xlazam01/OpenWheel/cad/diy/ofw_diy_bearing_mf105zz.png

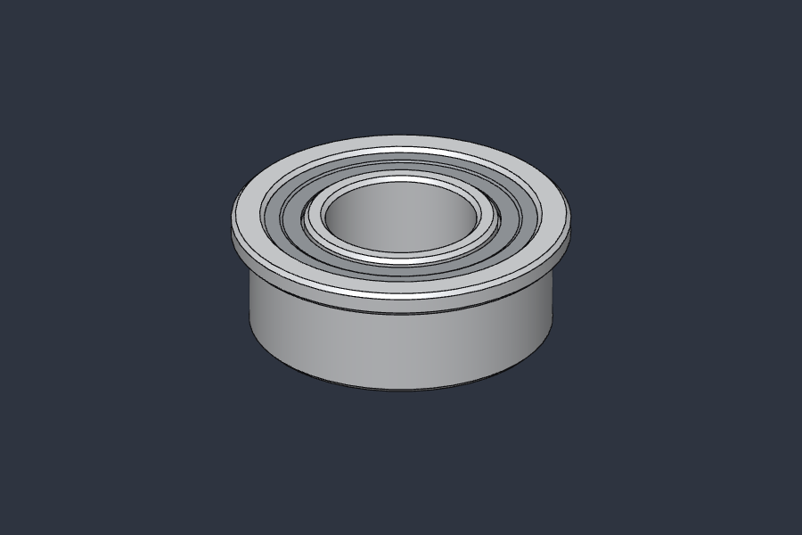
cad/diy/ofw_diy_bearing_mf105zz.png
