xlazam01/OpenWheel/cad/diy/ofw_diy_plate_camera.png

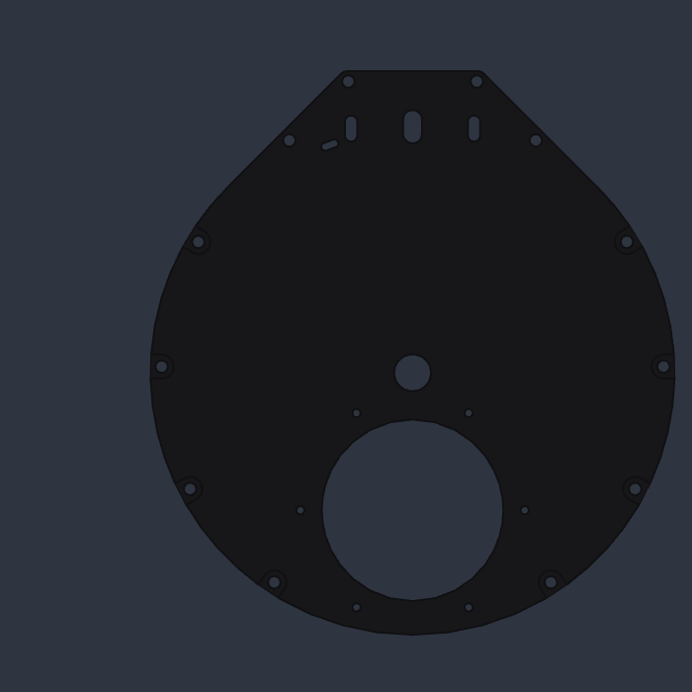
cad/diy/ofw_diy_plate_camera.png
