xlazam01/OpenWheel/cad/diy/ofw_diy_screw_m3x8_lowhead.png

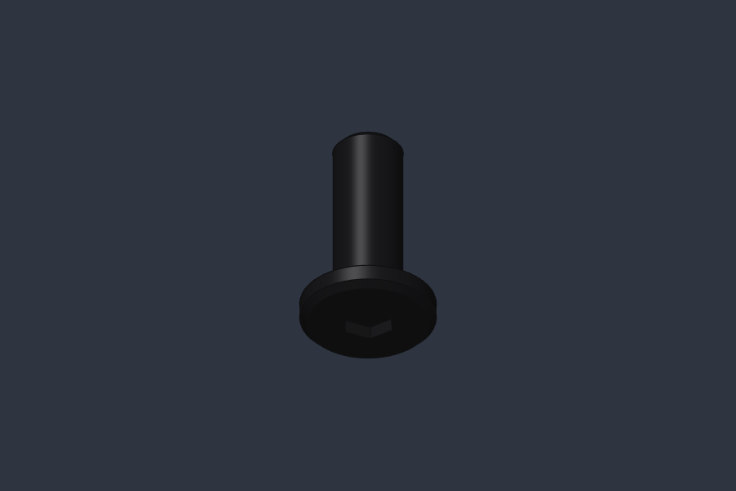
cad/diy/ofw_diy_screw_m3x8_lowhead.png
