xlazam01/OpenWheel/cad/diy/ofw_diy_shell.png

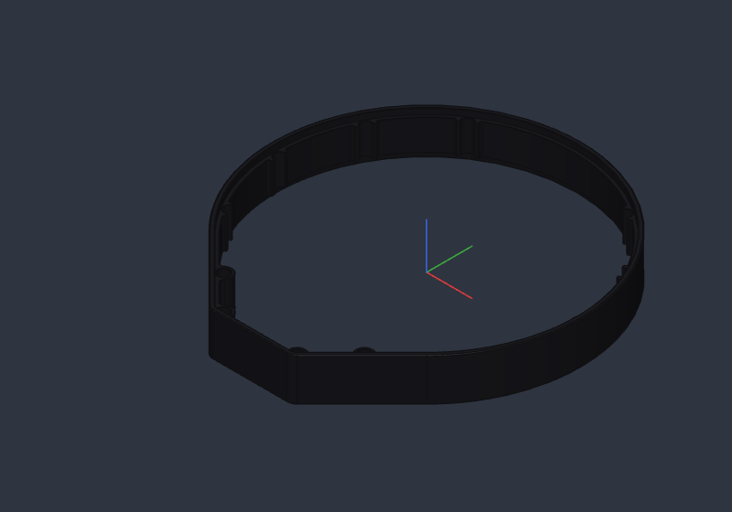
cad/diy/ofw_diy_shell.png
