xlazam01/OpenWheel/cad/diy/ofw_diy_wheel_asm.png

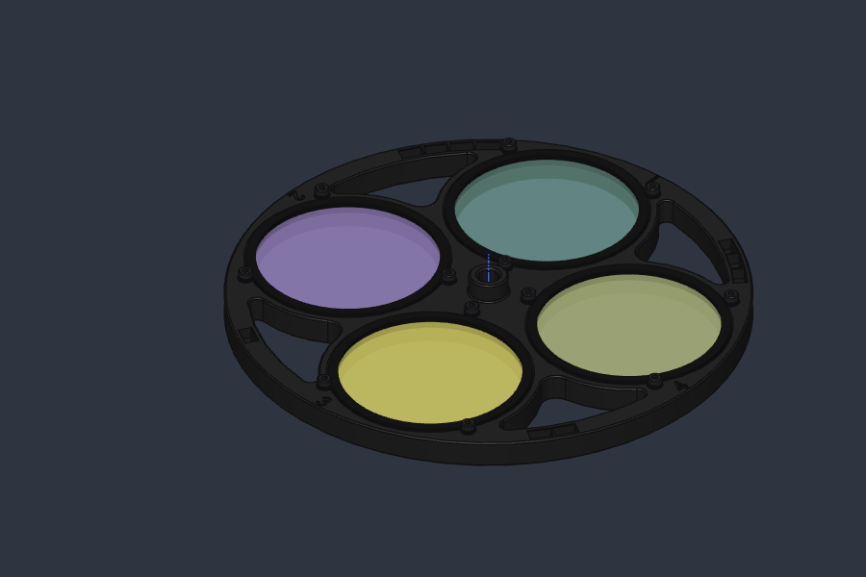
cad/diy/ofw_diy_wheel_asm.png
