xlazam01/OpenWheel/docs/hw/pcb_bottom.png

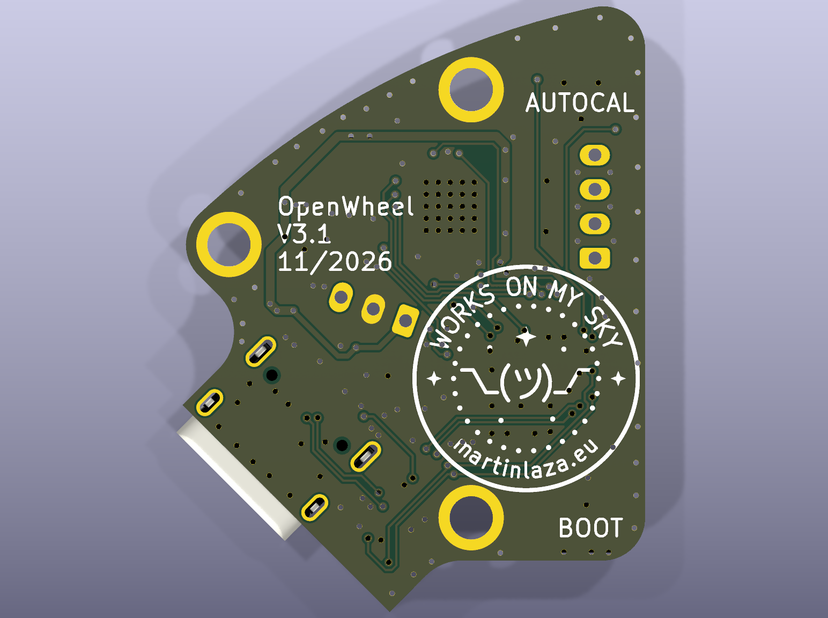
docs/hw/pcb_bottom.png
