xlazam01/OpenWheel/docs/hw/pcb_iso.png

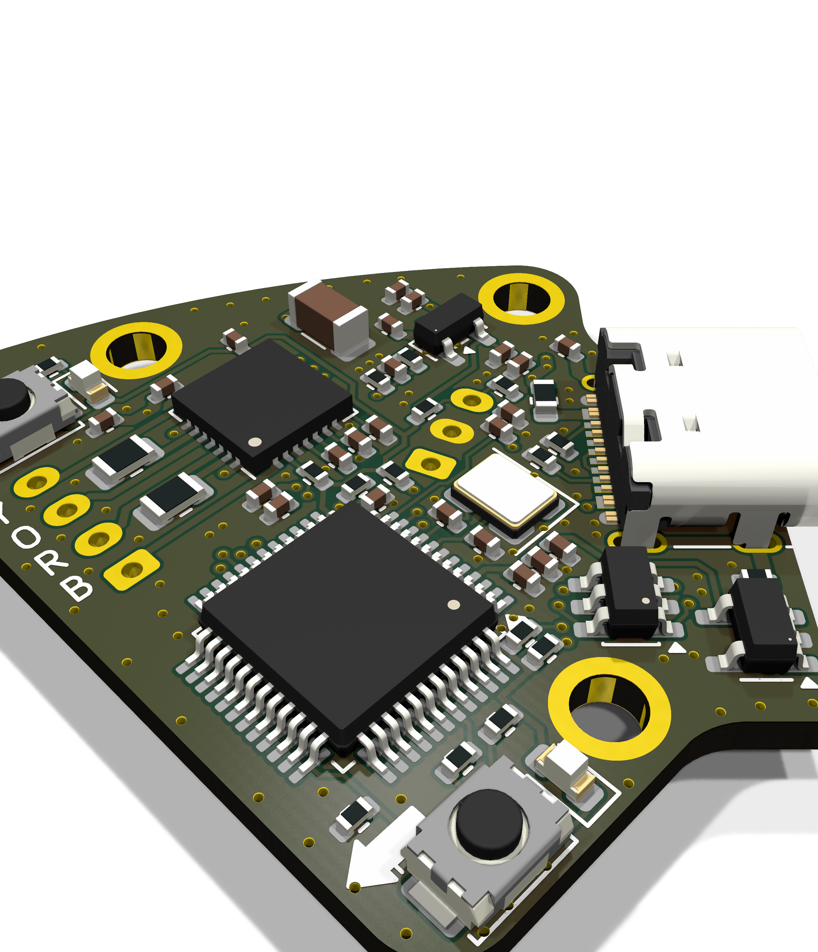
docs/hw/pcb_iso.png
