xlazam01/OpenWheel/docs/hw/pcb_top.png

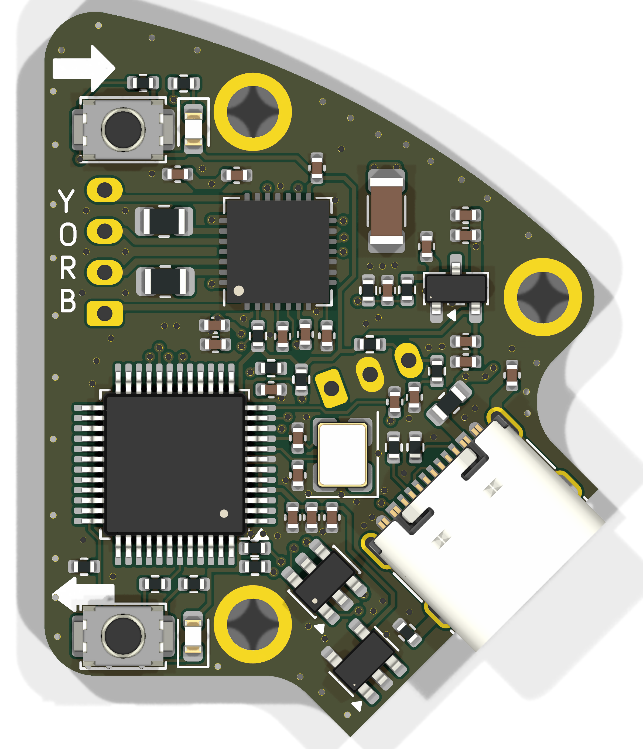
docs/hw/pcb_top.png
