xlazam01/OpenWheel/release/1.0.0/pcb/OpenWheel-bom-jlc.csv

Comment | Designator | Footprint | LCSC
4.7nF | C1 | C_0402_1005Metric | C1538
12pF | C11,C12 | C_0402_1005Metric | C1547
100nF/50V | C14,C15,C20,C22 | C_0402_1005Metric | C307331
47uF/10V | C18 | C_1206_3216Metric | C96123
22nF/50V | C19 | C_0402_1005Metric | C1532
1uF | C2,C3,C10 | C_0402_1005Metric | C52923
1nF | C24 | C_0402_1005Metric | C1523
100nF | C4,C7,C8,C9,C13,C23,C25 | C_0402_1005Metric | C1525
22nF | C5 | C_0402_1005Metric | C1532
10uF/10V | C6,C16,C17,C21 | C_0402_1005Metric | C315248
RED | D1,D2 | LED_0603_1608Metric | C2286
SMD0603P050TF | F1 | Fuse_0603_1608Metric | C20789
MC-311D | J1 | USB_C_Receptacle_G-Switch_GT-USB-7010ASV | C2988369
5k1 | R1,R2,R10,R11,R12,R13 | R_0402_1005Metric | C25905
1k5 | R15 | R_0402_1005Metric | C25867
0.11R | R16,R17 | R_0805_2012Metric | C5126077
100R | R19 | R_0402_1005Metric | C25076
1M | R3 | R_0402_1005Metric | C26083
10k | R4,R7,R9,R14,R18,R20,R21 | R_0402_1005Metric | C25744
510R | R8 | R_0402_1005Metric | C25123
CCW / BOOT0 | SW2 | SW_Push_SPST_NO_Alps_SKRK | C720477
CW | SW3 | SW_Push_SPST_NO_Alps_SKRK | C720477
USBLC6-2SC6 | U1 | SOT-23-6 | C2687116
RT9193-33 | U2 | SOT-23-5 | C15651
STM32G0B1CBTx | U3 | LQFP-48_7x7mm_P0.5mm | C2847904
24AA64T-I/OT | U4 | SOT-23-5 | C2061092
TMC2209-LA | U5 | QFN-28-1EP_5x5mm_P0.5mm_EP3.75x3.75mm_ThermalVias | C2150710
TAXM8M4RDBCCT2T / 8MHz | Y1 | Crystal_SMD_3225-4Pin_3.2x2.5mm | C400090
