xlazam01/OpenWheel/(list of files, cad)

Other CAD files:
cad/diy/ofw_diy_wheel_asm.step
cad/triton/ofw_triton_motor_plate.step
hw/3dmodels/Fuse_0603_1608Metric.step
release/1.0.0/cad/printed/ofw_diy_motorbox.3mf
release/1.1.0/cad/cnc/ofw_diy_plate_front.step
release/1.1.0/cad/printed/ofw_diy_wheel.step
release/1.1.0/pcb/kicad/hw/3dmodels/SW_Push_SPST_NO_Alps_SKRK.step
cad/diy/ofw_diy_shaft_5x20.step
cad/triton/ofw_triton_shell.3mf
release/1.0.0/cad/printed/ofw_diy_motorbox_lid.step
release/1.1.0/cad/printed/ofw_diy_motorbox.step
release/1.1.0/cad/printed/ofw_diy_shell.3mf
release/1.1.0/cad/printed/ofw_diy_motorbox_lid.3mf
cad/diy/ofw_diy_standoff_m3x15.step
cad/diy/ofw_diy_bearing_mf105zz.step
cad/diy/ofw_diy_shell.step
cad/diy/ofw_diy_wheel.step
cad/diy/ofw_diy_pcb_board.step
cad/diy/ofw_diy_shim_5x7x05.step
cad/diy/ofw_diy_shim_10x14x03.step
cad/diy/ofw_diy_pcb.step
cad/diy/GT-USB-7010ASV.step
cad/diy/ofw_diy_screw_iso7380_m3x16.step
cad/diy/ofw_diy_screw_iso7380_m3x8.step
cad/diy/ofw_diy_screw_m2x6_socket.step
cad/diy/ofw_diy_screw_m3x8_lowhead.step
cad/triton/ofw_triton_motor_plate.3mf
