xlazam01/OpenWheel/docs/build/page00.png

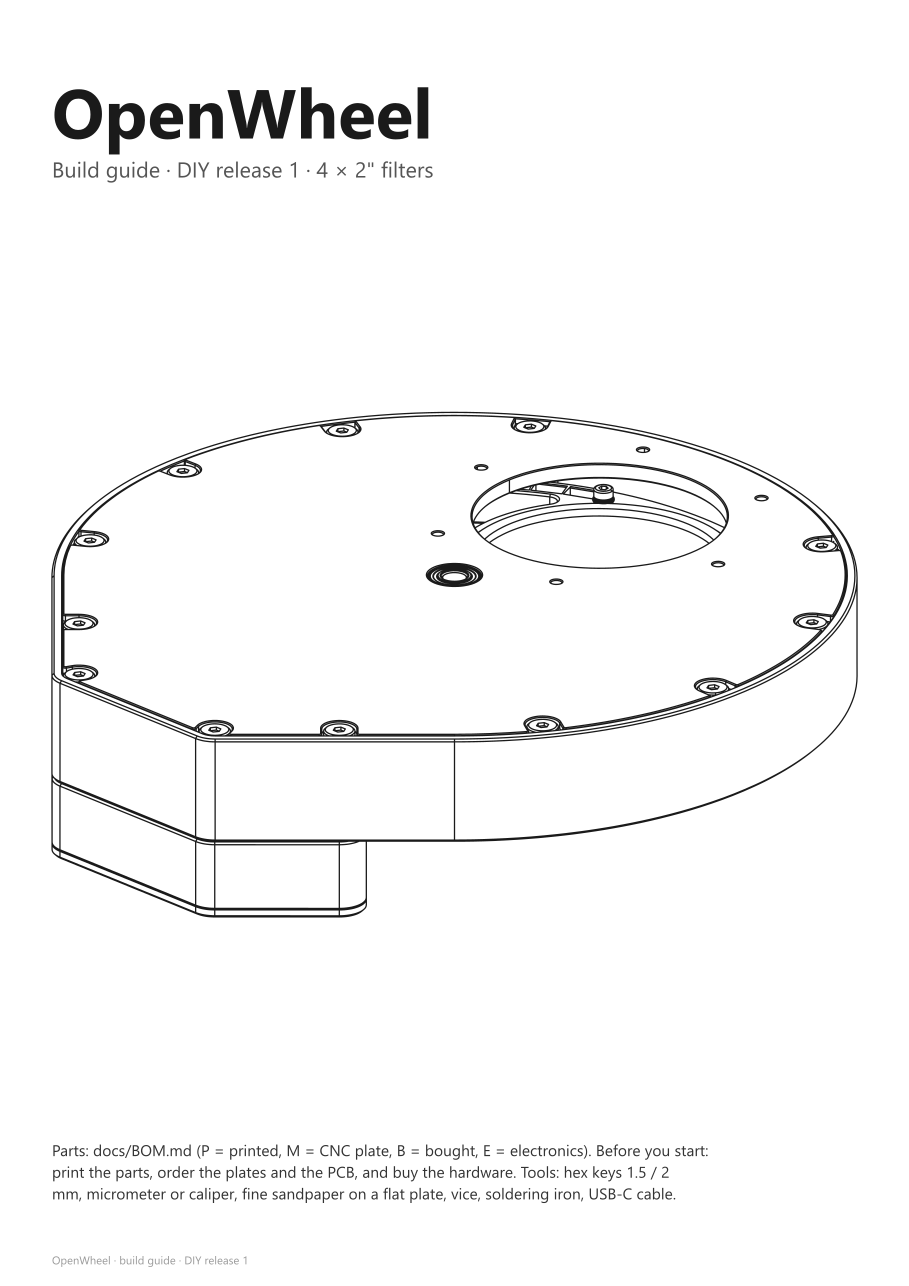
docs/build/page00.png
