xlazam01/OpenWheel/hw/filter_wheel.kicad_pcb

## KiCad design hw/filter_wheel.kicad_pcb (2026-11-09)

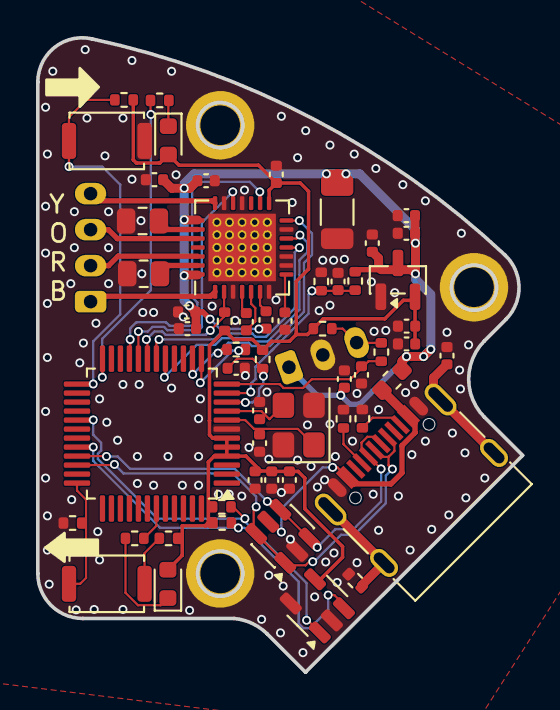
[picture p30: board filter_wheel.kicad_pcb from above]

Board: 2 copper layers, 26.9 x 35.2 mm, 61 parts (1 on the bottom side), 41 nets.

Parts:
C1: 4.7nF; C_0402_1005Metric
C2, C3, C10: 1uF; C_0402_1005Metric
C4, C7, C8, C9, C13, C14, C15, C20, C22, C23, C25: 100nF; C_0402_1005Metric
C6, C16, C17, C21: 10uF/10V; C_0402_1005Metric
C11, C12: 12pF; C_0402_1005Metric
C18: 47uF/10V; C_1206_3216Metric
C19: 22nF/50V; C_0402_1005Metric
C24: 1nF; C_0402_1005Metric
D1, D2: RED; LED_0603_1608Metric
F1: SMD0603P050TF; Fuse_0603_1608Metric
G1: Logo_WorksOnMySky_13mm
H1, H2, H3: M2; MountingHole_2.2mm_M2_DIN965_Pad
J1: MC-311D; USB_C_Receptacle_G-Switch_GT-USB-7010ASV
J3: Motor; JST_PH_B4B-PH-K_1x04_P2.00mm_Vertical
J4: Hall; JST_PH_B3B-PH-K_1x03_P2.00mm_Vertical
R1, R2, R10, R11, R12, R13: 5k1; R_0402_1005Metric
R3: 1M; R_0402_1005Metric
R4, R7, R9, R14, R18, R20, R21: 10k; R_0402_1005Metric
R8: 510R; R_0402_1005Metric
R15: 1k5; R_0402_1005Metric
R16, R17: 0.11R; R_0805_2012Metric
R19: 100R; R_0402_1005Metric
SW2: CCW / BOOT0; SW_Push_SPST_NO_Alps_SKRK
SW3: CW; SW_Push_SPST_NO_Alps_SKRK
U1: USBLC6-2SC6; SOT-23-6
U2: ME6231A33M3G; SOT-23
U3: STM32G0B1CBTx; LQFP-48_7x7mm_P0.5mm
U4: 24AA64T-I/OT; SOT-23-5
U5: TMC2209-LA; QFN-28-1EP_5x5mm_P0.5mm_EP3.75x3.75mm_ThermalVias
Y1: TAXM8M4RDBCCT2T / 8MHz; Crystal_SMD_3225-4Pin_3.2x2.5mm

Connections:
+3.3V: C6.1, C7.1, C8.1, C9.1, C10.1, C22.2, D1.2 (A), D2.2 (A), R4.2, R8.2, R9.2, R12.2, R13.2, R14.2, R18.1, U2.2, U3.4 (VBAT), U3.5 (VREF+), U3.6 (VDD), U4.4 (V_{CC}), U5.15 (VCC_IO)
+5V: C2.2, C3.1, C4.1, C14.2, C15.2, C16.2, C17.2, C18.1, C20.1, C23.1, F1.2, J4.1, R20.1, U2.3, U5.22 (VS), U5.28 (VS)
/BTN_CCW: R8.1, SW2.2
/BTN_CW: R9.1, SW3.2, U3.25 (PB13)
/HALL: C24.1, R19.2, U3.12 (PA1)
/HALL_IN: J4.3, R18.2, R19.1
/I2C_SCL: R12.1, U3.29 (PA9/UCPD1_DBCC1), U4.1 (SCL)
/I2C_SDA: R13.1, U3.32 (PA10/UCPD1_DBCC2), U4.3 (SDA)
/LED1: R10.1, U3.24 (PB12)
/LED1_K: D1.1 (K), R10.2
/LED2: R11.1, U3.43 (PB4)
/LED2_K: D2.1 (K), R11.2
/MOT_A1: J3.3, U5.24 (OA1)
/MOT_A2: J3.4, U5.21 (OA2)
/MOT_B1: J3.2, U5.26 (OB1)
/MOT_B2: J3.1, U5.1 (OB2)
/NRST: C13.1, R4.1, U3.10 (PF2)
/OSC_IN: C11.1, U3.8 (PF0), Y1.1
/OSC_OUT: C12.1, U3.9 (PF1), Y1.3
/SWCLK_BOOT0: R7.2, SW2.1, U3.36 (PA14)
/TMC_5VOUT: C21.2, U5.8 (5VOUT)
/TMC_BRA: R16.1, U5.23 (BRA)
/TMC_BRB: R17.1, U5.27 (BRB)
/TMC_CPI: C19.1, U5.5 (CPI)
/TMC_CPO: C19.2, U5.4 (CPO)
/TMC_DIAG: U3.18 (PA7), U5.11 (DIAG)
/TMC_DIR: U3.20 (PB1), U5.19 (DIR)
/TMC_EN: R14.1, U3.19 (PB0), U5.2 (~EN)
/TMC_INDEX: U3.17 (PA6), U5.12 (INDEX)
/TMC_STEP: U3.21 (PB2), U5.16 (STEP)
/TMC_TX: R15.2, U3.13 (PA2)
/TMC_UART: R15.1, U3.14 (PA3), U5.14 (~PD/UART)
/TMC_VCP: C20.2, U5.6 (VCP)
/USB_CC1: J1.A5 (CC1), R1.1
/USB_CC2: J1.B5 (CC2), R2.1
/USB_DM: J1.A7 (D-), J1.B7 (D-), U1.3 (I/O2), U1.4 (I/O2), U3.33 (PA9/PA11)
/USB_DP: J1.A6 (D+), J1.B6 (D+), U1.1 (I/O1), U1.6 (I/O1), U3.34 (PA10/PA12)
/USB_SHIELD: C1.1, J1.S1 (SHIELD), R3.1
/V5_SENSE: C25.1, R20.2, R21.1, U3.11 (PA0)
GND: C1.2, C2.1, C3.2, C4.2, C6.2, C7.2, C8.2, C9.2, C10.2, C11.2, C12.2, C13.2, C14.1, C15.1, C16.1, C17.1, C18.2, C21.1, C22.1, C23.2, C24.2, C25.2, H1.1 (1_1), H2.1 (1_1), H3.1 (1_1), J1.A1 (GND), J1.A12 (GND), J1.B1 (GND), J1.B12 (GND), J4.2, R1.2, R2.2, R3.2, R7.1, R16.2, R17.2, R21.2, SW3.1, U1.2 (GND), U2.1, U3.7 (VSS), U4.2 (V_{SS}), U4.5 (WP), U5.3 (GND), U5.7 (SPREAD), U5.9 (MS1/AD0), U5.10 (MS2/AD1), U5.13 (CLK), U5.18 (GND), U5.20 (STDBY), U5.29 (GND), Y1.2 (G), Y1.4 (G)
VBUS: F1.1, J1.A4 (VBUS), J1.A9 (VBUS), J1.B4 (VBUS), J1.B9 (VBUS), U1.5 (VBUS)
