xlazam01/OpenWheel/tools/gui/main.py

"""
OpenWheel Filter Control Application
Main entry point
"""

import sys
from PyQt5.QtWidgets import QApplication
from main_window import MainWindow


def main():
    app = QApplication(sys.argv)
    app.setStyle('Fusion')  # Modern look

    window = MainWindow()
    window.show()

    sys.exit(app.exec_())


if __name__ == "__main__":
    main()
