xlazam01/OpenWheel/(commit log)

2026-11-05 feat: OpenWheel open-source filter wheel
    STM32G0B1 firmware, KiCad PCB (V3.1), SolidCraft DIY mechanics with
    printable parts and STEP exports, ASCOM and INDI drivers, test GUI,
    hardware acceptance tests, build guide, BOM and user manual.
2026-11-06 feat(fw): enter DFU via RAM flag and reset instead of a direct jump
    :31# now writes a magic value (0xB00710AD + complement) to the top 8 bytes
    of SRAM and resets. A .preinit_array hook, which runs before STM32duino's
    premain() and any HAL/clock/USB init, sees the flag, clears it and jumps to
    the ROM bootloader with every peripheral still in reset state.
    The flag is kept out of the linker's RAM region by
    board_upload.maximum_ram_size = 144 KB - 8, so _estack sits below it and
    no data, bss, heap or stack can touch it. The old direct jump stays
    behind -D OPENWHEEL_DFU_DIRECT_JUMP for rollback.
    Tested on a rev 1 board: :31# -> DFU (0483:df11), flash via pio and plain
    dfu-util, firmware boots;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
2026-11-06 feat(fw): enter DFU via RAM flag and reset instead of a direct jump (#15)
    dfu-util, firmware b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
2026-11-06 feat: identify first - reject commands until :32# (protocol 3) (#17)
    * feat(fw): identify first - reject commands until :32# (protocol 3)
    After power-on and whenever a host opens the USB port, the firmware accepts
    only :25# (ping) and :32# (identify); every other command answers ERR,16
    (not identified) and does nothing. Port open is detected from the CDC class
    requests SET_LINE_CODING / SET_CONTROL_LINE_STATE via a link-time wrap of
    USBD_LL_SetupStage; the firmware still does not gate on DTR. Measured on
    Windows 11: close + open sends both requests with DTR false or true.
    Protocol version 3, firmware FW1.4.0, error 16 (same as AstroUniBoard).
    Refs #16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
2026-11-06 feat(hw): bottom logo, track clean-up, GND stitching vias (#18)
    * feat(hw): logo on the bottom, track clean-up and 3D model fixes
    Bottom silkscreen
    - "works on my sky" logo (myLib_Logo:Logo_WorksOnMySky_13mm) behind the MCU.
    - Version text re-stacked as OpenWheel / V3.1 / 11/2026 (the logo carries
    martinlaza.eu); stale off-board "FilterWheel v1" text removed.
    Track clean-up (DRC-gated, schematic parity unchanged)
    - Jogged runs replaced by the simplest 45-degree path where not longer and
    clear of other nets: 530 -> 377 segments.
    - Dangling stubs and tiny pad-centre stubs removed.
    Fixes
    - 3D models point at existing KICAD10 STEP files; J3/J4 (JST, not populated)
    hidden; J1 uses the GC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
2026-11-06 docs: re-render PCB views and show them in the README (#19)
    Top, bottom and 3D renders regenerated with kicad-cli (KiCad 10) from the
    current board (bottom logo, new stitching vias); README embeds them below
    the spec table.
2026-11-06 feat: release 1.0.0 (firmware, PCB fabrication files, DIY CAD exports) (#21)
    release/1.0.0 holds FW1.4.0 (.bin), JLCPCB gerbers/BOM/CPL and the
    schematic for PCB V3.1, and the DIY release-1 CAD exports (3MF + STEP for
    printed parts, STEP for the CNC plates and assemblies), with checksums
    and print/ordering notes. README and DIY notes link to it.
    Closes #5
2026-11-07 feat(hw): self-contained KiCad project (project libraries and 3D models) (#23)
    Every symbol, footprint and 3D model now comes from the project itself
    (openwheel.kicad_sym, OpenWheel.pretty, 3dmodels/ via ${KIPRJMOD}), so the
    project opens on any machine without missing libraries. DRC: 45 footprint
    library mismatches -> 0, ERC 0, connectivity unchanged. Drops the personal
    STEP export path from the project file. Packed with Astro tools/kicad/libpack.py.
2026-11-08 chore(hw): unify footprint copies and capacitor value spelling (#24)
    - C1, C23-C25, R3, R19-R21: back on the base 0402 footprints; their fab and
    courtyard outlines are redrawn as the library draws them, and the five
    identical _v2.._v4 copies are removed from OpenWheel.pretty
    - C5: 22nF -> 22nF/50V, same part (C1532) and spelling as C19
    Connectivity unchanged (netcompare), DRC 0 items, libpack self-contained.
2026-11-08 fix(hw): close gaps in the board outline (#26)
    Three Edge.Cuts joints did not meet exactly (6 um, 33 nm, 23 nm). KiCad
    tolerates this, but KiKit rejects the outline as discontinuous, so the
    board could not be panelized. The unlocked segment of each joint now ends
    exactly on its neighbour; GND zones refilled. DRC: 0 items.
2026-11-09 feat(cad): Triton variant - shell with horns, rotator motor housing and plate (#27)
    Parts that turn the DIY wheel into the Triton variant (cad/triton/):
    - ofw_triton_shell: links the DIY shell and adds the two horns for the OAG
    guide-camera focuser drive, copied from the legacy ofw4_shell
    - ofw_triton_rot_housing / ofw_triton_motor_plate: OpenRoto motor housing
    and slotted plate, rebuilt from the legacy STEPs; slots give a centre
    distance of 93.8-98.7 mm, the 340 mm GT2 belt needs 97.90 mm
    cad/diy/ofw_diy_shell.sc: re-picked the edges of five fillet/chamfer
    features so the shell opens without warnings; geometry unchanged.
    All parts: no feature warnings, closed meshes, print without s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
2026-11-09 feat(cad): Triton variant assembly and deeper motor plate belt recess (#28)
    * feat(cad): add the Triton variant assembly of the wheel
    DIY assembly with the Triton shell, rotator housing and motor plate (belt-tensioned
    position). Linked by Triton's system assembly (xlazam01/Triton#8).
    * fix(cad): deepen the Triton motor plate belt recess to 2.6 mm
    In Triton's system assembly the 340 mm belt rubbed the 2.0 mm recess by 0.25 mm;
    2.6 mm leaves 0.35 mm. Cusp cuts stay at counterbore depth to avoid 0.01 mm slivers.
    cad-check and print-check pass.
    ---------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
2026-11-09 feat(cad): Triton rotator holder finish and fasteners (#29)
    * feat(cad): red PETG finish and fasteners for the Triton rotator holder
    Housing and motor plate get the printed red PETG look. New linked fastener designs
    (DIN 912 M3x30 and M3x16, ISO 7380 M3x5, DIN 433 M3 washer) are placed in the
    Triton assembly; the M3x30 replace the four DIY front-plate screws under the housing.
    * fix(cad): OpenWheel red, stainless screws, button heads in the plate slots
    Housing and plate use OpenWheel's PETG red look (#c8201e, as the motor box). All
    holder screws are stainless A2; the slot screws are ISO 7380 M3x16 button heads
    with DIN 433 washers i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
2026-11-09 feat(hw): ME6231A33M3G LDO (shared with AstroUniBoard), 16 V decoupling caps (#30)
    - U2 RT9193-33 (SOT-23-5, Extended) -> ME6231A33M3G (SOT-23, C2765181): the
    same regulator as AstroUniBoard U1, so a joint AUB + OpenWheel order pays one
    setup fee less; 500 mA, 1.8 uA Iq. C5 (bypass-pin cap) and the EN wiring
    removed. New symbol, SOT-23 footprint and 3D model in the project libraries
    (still self-contained). Copper around U2 re-routed: +5V via moved 0.3 mm,
    two GND stitching vias removed, old EN stub into the new VIN pad.
    - C14, C15, C20, C22 100nF/50V -> 100nF/16V (C1525): at most 5 V across them.
    - docs: BOM.md and bom/electronics.csv (regenerated), schematic PDF and PCB
    renders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
2026-11-09 chore(hw): board V3.2 (#31)
    The ME6231A33M3G LDO swap and 16 V decoupling caps (#30) change the BOM and
    copper, so the board gets a new version: back silkscreen V3.1 -> V3.2,
    schematic title block rev 3.2 (was 1.0, now matches the silkscreen), date
    2026-11-09. README caption, schematic PDF and bottom render updated.
    Firmware unchanged (FW1.4.0). DRC 0.
2026-11-09 feat: release 1.1.0 (PCB V3.2, self-contained KiCad project) (#32)
    - pcb/: gerbers, JLC BOM/CPL (55 parts, all LCSC) and schematic PDF for
    board V3.2 (ME6231A33M3G LDO, 16 V decoupling caps); DRC 0.
    - pcb/kicad/: the KiCad project packed self-contained (libpack, verified
    on a clean KiCad configuration).
    - firmware/: FW1.4.0, rebuilt and byte-identical to the 1.0.0 binary.
    - cad/: shell re-exported (the 1.0.0 STEP had six zero-area faces; same
    volume and bbox); other parts unchanged since 1.0.0, 1.0.0 exports.
    - README, SHA256SUMS; repo README points to 1.1.0.
