xlazam01/OpenWheel/(notices)

Notices in the files:
hw/filter_wheel.kicad_sch:
Licence: CERN-OHL-S-2.0
